Slavaromanenko3424/Analog_electronics/Course_work/Pictures/DSC_0113.jpg

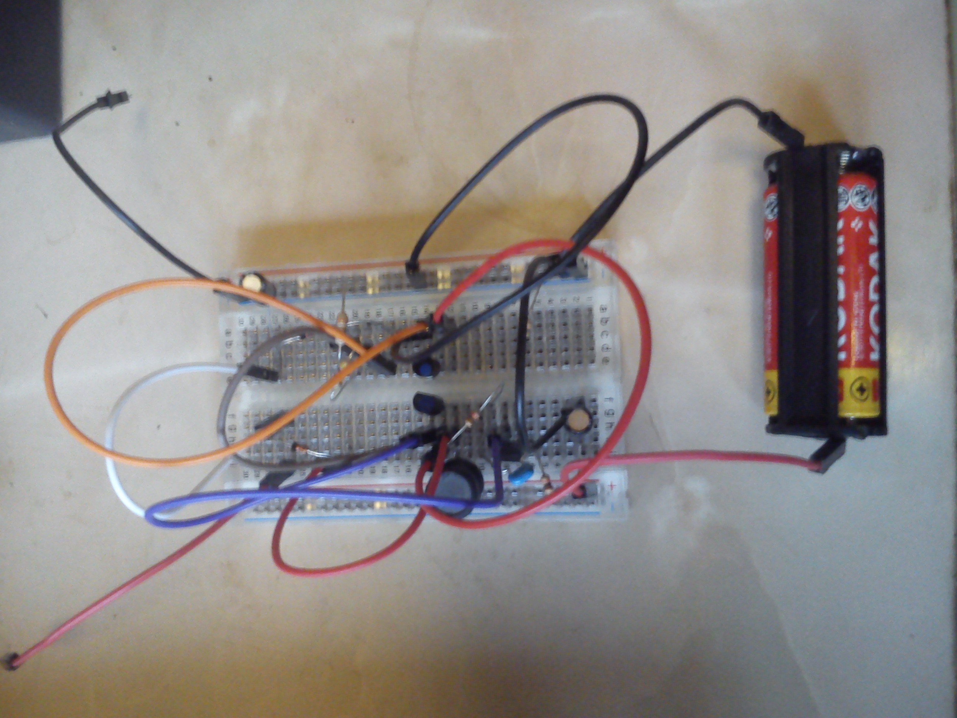
Course_work/Pictures/DSC_0113.jpg
