Slavaromanenko3424/Analog_electronics/Course_work/Pictures/r.png

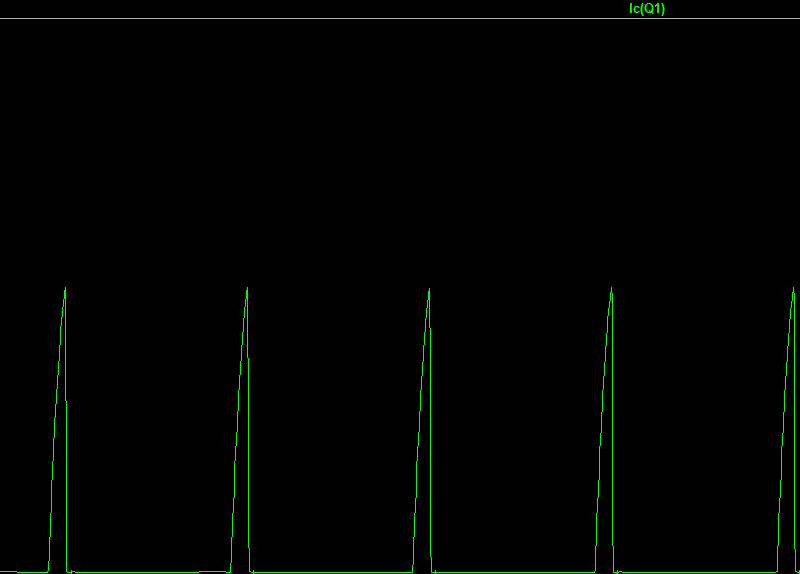
Course_work/Pictures/r.png
