Slavaromanenko3424/Analog_electronics/Course_work/Pictures/Безымянный.png

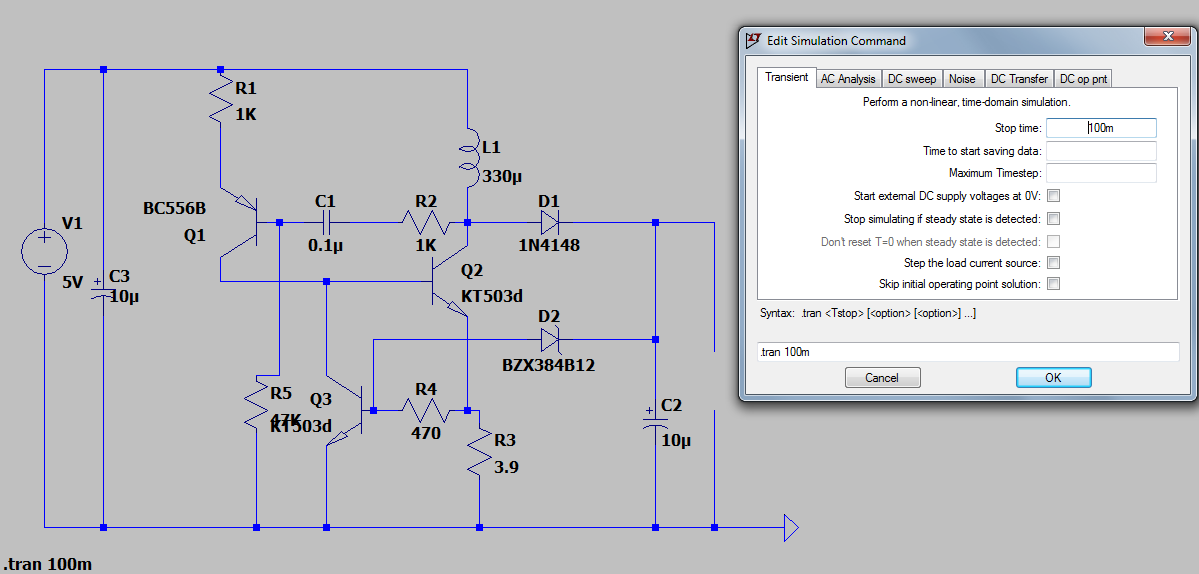
Course_work/Pictures/Безымянный.png
