Slavaromanenko3424/Analog_electronics/Course_work/Pictures/График.png

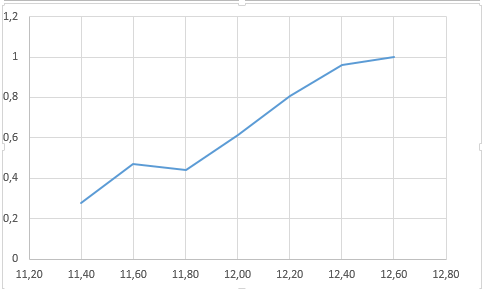
Course_work/Pictures/График.png
