Slavaromanenko3424/Analog_electronics/Course_work/Simulation/курсач.asc

C1: cap; 0.1µ
C2: polcap; 10µ; V=12.5 Irms=2.12132 Rser=0.06 Lser=0 mfg="KEMET" pn="A700V106M12RATE060" type="Al electrolytic"
C3: polcap; 10µ; V=12.5 Irms=2.12132 Rser=0.06 Lser=0 mfg="KEMET" pn="A700V106M12RATE060" type="Al electrolytic"
D1: diode; 1N4148
D2: zener; BZX384B12
L1: ind; 330µ; Ipk=0.06 Rser=16.424 Rpar=31086 Cpar=0 mfg="Coilcraft" pn="0805PS-334"
Q1: npn; KT503d
Q2: npn; KT503d
Q3: pnp; BC556B
R1: res; 1K; tol=1 pwr=0.1
R2: res; 1K; tol=1 pwr=0.1
R3: res; 3.9
R4: res; 470
R5: res; 47K; tol=1 pwr=0.1
V1: voltage; 5V
Named nets: 0
.tran 40m
Vout +12.6 V
Vin +5V
GND
GND
